snow-wind-001/MecanumWheelvehicle/3D/IMG_20170406_211856_AO_HDR.jpg

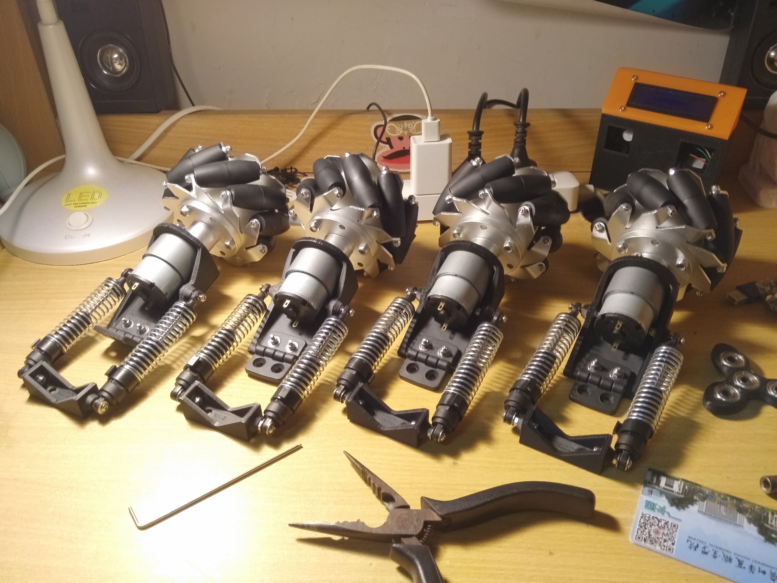
3D/IMG_20170406_211856_AO_HDR.jpg
