snow-wind-001/MecanumWheelvehicle/3D/IMG_20170523_214143_AO_HDR.jpg

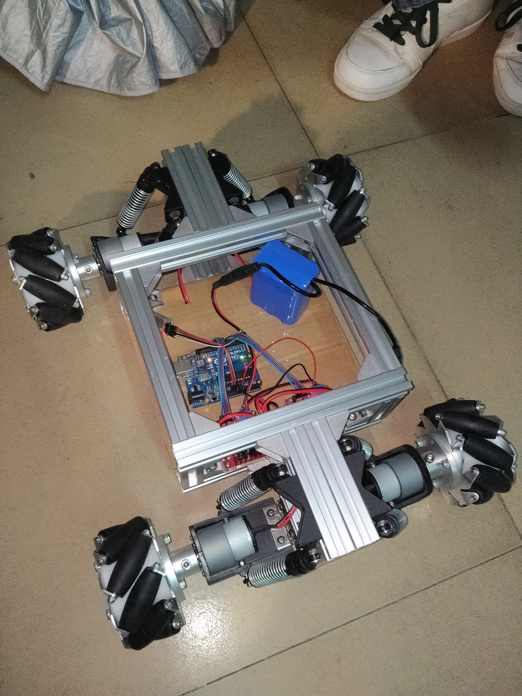
3D/IMG_20170523_214143_AO_HDR.jpg
