snow-wind-001/MecanumWheelvehicle/Code/docs/代码与电路一致性复核_v1.md

# 代码与电路一致性复核 v1

2026-10-25。范围：当前 STM32 编译工程、MAVLink / ROS / Pi 部署、参数与健康保护，以及最终原生工程归档中的 PCB2 / PCB3_1。只发布最终文件，历史备份、过程日志及候选路由保留在本地。

## 结论与依据

本轮修复了代码中的具体缺陷，当前 80 项主机测试通过，STM32 全量构建零告警，ESP32 与两个 ROS 包构建通过。归档中 64 个必需 MCU 引脚与引脚基线一致，主 GPIO 宏匹配；A/B 60 位信号接口、8 位电源接口匹配。该检查不等于所有外设已在实板正常工作，也不是工业验收证明。

电路依据为 `PCB/backups/PCB3_1_routing_complete.epro2`，不是旧版导出或当前未保存窗口。机器报告保存归档 SHA256；后续如果更换归档，应重跑检查。

- PCB2 UUID：`9fb4ea4c3f4a2c99`，MCU U10 / STM32F429ZGT6，LQFP144。
- PCB3_1 UUID：`d5bab27b5a49d1b7`，电源与电机驱动板。
- 程序入口：`Code/MecanumB_Control/Makefile`，默认 `VEHICLE_LINK_PROTOCOL_MAVLINK=1`。
- 仅发布一份完整 EDA 归档和 `3D/Vehicle Layout v15.blend`；本轮未修改机械几何、PCB 元件布局或布线。

## 已修复问题

| 问题 | 修复与验证 |
| --- | --- |
| 启动擦除 Flash 期间可能被外部看门狗复位 | 不再擦除空白槽；必须擦除时在 `.RamFunc` 中关中断轮询，每 20 ms 为 PG12 提供 WDI 下降沿，电机 ARM/MOE 保持关闭。3 s 超时停止喂狗等待外部复位；完成后刷新 Flash 缓存。ELF 检查确认函数位于 SRAM 且没有子程序调用；实际擦除波形仍待实测 |
| 参数保存与解锁竞争 | 同一临界区检查 DISARMED、无待确认授权、配置有效并获取 `maintenance`。MAVLink / legacy 解锁和运动许可全部受维护联锁约束；编程进行中不能被截止时间提前解锁，完成后保持 20 ms 才释放 |
| 电流阈值与驱动/电机不匹配 | 根据用户提供的 MG370 单电机约 1 A 堵转电流，采用待标定 1.2 A / 20 ms 过流和 0.8 A / 低速 / 500 ms 堵转阈值，可用宏覆盖；新增约 1 A 输入的堵转测试 |
| 清除计时在滞回带中累计 | 过流、欠压、过温只在满足恢复条件时连续计时；条件中断即清零。添加“长时间滞回带 + 一次恢复采样不能清故障”测试 |
| 损坏 Flash 头部使后续记录不可见或重写非空槽 | 固定 84 字节槽逐项扫描，跳过非空损坏记录；只在完全擦除槽追加。测试模型严格执行 Flash 位只能 1→0，覆盖损坏中间头、损坏尾、CRC 回退与满槽轮换 |
| SBUS 高电平重新授权、缓存样本延长租约 | LOW→HIGH 只消费一次；未出现新 LOW 时不能在上锁后自动重解锁。租约以物理帧时间为准，相同时间戳不续租；failsafe 立即撤权。生产默认仍关闭本地运动权，专门以启用宏编译测试 |
| Pi 默认部署启动 legacy 节点 | `mecanum-bridge.service` 改为启动 `mecanum_mavlink`；配置也须使用同名包的 YAML，避免协议不匹配 |
| 关机 ACK 丢失后重试被拒绝 | 对已接受的同一 Pi 关机请求幂等 ACK，不重复触发电源状态机；READY 只在接受 ACK 后因关机而拉低 |
| 无效 ADC 仍可能上报旧 NTC 温度为有效 | NTC 有效性必须同时满足 ADC 有效；添加启用 NTC 编译分支测试 |
| CPU 负载计算无符号下溢与 DWT 频繁回绕 | 空闲百分比先限幅再相减；DWT 先扩展再转为微秒用于 RTOS 统计。统计计数仍为 32 位，约 71 分钟回绕；跨回绕瞬间的任务统计存在上游内核精度边界，不能作为高精度测量 |

## 硬件映射与电气参数

| 项目 | 归档连接/名义值 | 程序处理 |
| --- | --- | --- |
| FL/FR/RL/RR PWM | PE9/PE11/PE13/PE14，TIM1_CH1–4 | 20 kHz PWM，硬件 Break 与许可共同约束 |
| 编码器 | FL PA15/PB3；FR PA6/PA7；RL PB6/PB7；RR PA0/PA1 | TIM2/3/4/5，16/32 位回绕差分；方向与 CPR 待标定 |
| 驱动故障/急停 | PG4–PG7、PG11；PE15 MOTOR_INHIBIT | 故障锁存、撤销授权、关闭 ARM/MOE |
| 电流 ADC | PC0–PC3 = IN10–13；板间 39/41/43/45 | 50 mΩ × 10 V/V = 名义 0.5 V/A，ADC 按轮序采集 |
| 电压 ADC | PC4/PC5 = IN14/15；板间 47/48 | 120 kΩ / 10 kΩ，即分压比 13 |
| 外接 NTC | PB1 = IN9；板间 49 | 电路为 10 kΩ 上拉、100 Ω 串联及 100 nF；探头型号/Beta 未确认，默认关闭 |
| Pi | USART6 PG14/PG9，921600 8N1 | MAVLink 双通道之一；READY PD0、HALTED PD1、关机请求 PC6、切电 PD3 |
| ESP32 | USART1 PA9/PA10，921600 8N1 | 桥的 RX16/TX17 对应 MCU TX/RX，注意按信号方向接线 |
| 外部看门狗 | A U11 TPS3431，EN/SET1 高，CWD 经 10 kΩ 上拉 | 名义 200 ms；PG12 WDI 经板间 31，WDO 经板间 55 接 MCU 25 NRST |
| 预留未接 | PD8 LD06_TX、PC10/PC11 POSE、PE0/PE1 LOG | 归档没有对应 MCU 铜网络；软件初始化不代表具有可用硬件接口 |

STSPIN948 的 MODE1/2/3 为 0/1/0，采用双独立全桥固定关断时间限流。REF 网络名义 1.5 V、增益 10、50 mΩ，推导硬件电流阈值约 3 A；旧 6 A 过流、3 A 堵转设置不能作为这台 1 A 堵转电机的合理保护基线。推导基于电路和器件关系，未包含误差与真实 PWM 波形校准。[STSPIN948 数据手册](https://www.st.com/resource/en/datasheet/stspin948.pdf)

TPS3431 在当前 CWD/SET1 配置下名义 200 ms，范围 170–230 ms。推迟内部 IWDG 初始化不能规避一直启用的外部看门狗，因此必须处理 Flash 忙时 CPU 无法从同组 Flash 取指的问题。[TPS3431 数据手册](https://www.ti.com/lit/ds/symlink/tps3431.pdf)、[STM32F4 参考手册 RM0090](https://www.st.com/resource/en/reference_manual/dm00031020-stm32f4xxx-advanced-armbased-32bit-mcus-stmicroelectronics.pdf)

## 参数存储与启动

程序 Flash 为 768 KiB；扇区 10/11 分别从 `0x080C0000` / `0x080E0000` 开始，各 128 KiB。每条记录 84 字节：魔数、版本、配置长度、序号、CRC32、boot_id 与 64 字节配置；每扇区容纳 1560 条记录。

启动扫描最新有效记录，CRC 与参数范围都通过后 `configured=1`；无有效记录则 `configured=0`，拒绝解锁。运行期仅 DISARMED 且配置稳定 750 ms 才追加，永不运行期擦扇区；写满下次启动轮换。保存后回读验证，失败通过 `cfg_err` 诊断；连续编辑时只清除对应版本的 dirty。

上电和加载有效参数都不会自动解锁。Pi 源仍必须满足真实 READY、电源和 HALTED 联锁；其他来源也必须显式授权并具有新鲜指令与租约。整片擦除会清掉持久化参数，烧录策略必须保留参数区。

## 健康保护的真实边界

- 过流：>1.2 A 持续 20 ms；全部轮 ≤0.6 A 连续 1 s 恢复。阈值来自电机规格输入，未完成电流零点/量程校准。
- 堵转：有运动许可、占空比绝对值 >0.1、采样电流 >0.8 A、轮速 <1 rad/s 持续 500 ms；条件消失 2 s 恢复。
- 欠压：按假定 4S 单体 <3.3 V 持续 1 s 触发，>3.5 V 连续 2 s 恢复；电池类型与分压实测须确认。
- NTC：过温分支支持 75 °C / 1 s 与 60 °C / 2 s 恢复，但默认 `VH_NTC_ENABLED=0`，现版不能宣称已启用温度保护。
- ADC 无效持续 1 s 产生传感器故障；有效性恢复不自动恢复运动授权。
- SOC 只按 4S 电压线性估算，不是 BMS，不测单体、库仑量或均衡。
- TIM8 ADC 与 TIM1 PWM 同为 20 kHz，但并未硬件锁定采样相位；DMA 当前交接末次扫描，不是每 PWM 周期平均电流。驱动低侧采样在某些占空比/续流状态可能低估实际电流，必须台架验证有效采样窗口，不能仅凭换算公式证明可靠保护。

## FreeRTOS、Pi 与验收

7 个静态任务：Safety 15、Control 14、HostRx 11、Imu 10、SensorRx 8、Telemetry 7、Power 6。Control 由 TIM6 通知，目标 1 kHz；维护期间硬件输出关闭且不计入常态抖动样本。CPU、最大/最近抖动、7 个任务栈高水位有遥测通路，尚无实测数值。

MAVLink 关机只允许 Pi 通道、`param1=0/param2=2`、未运动且 READY 有效；接受后 inhibit，再等待停轮与真正内核 HALTED，最后单次切电。ROS 不伪造 HALTED。Pi 的 `config-halted-pending.txt` 未作为已验证配置启用；不合并它时，不能指望 Linux 自动提供 HALTED，系统应超时保电并报故障。

## 软件验证结果

| 检查 | 结果 |
| --- | --- |
| STM32 全量 GCC 构建 | 成功，0 warning；FLASH 78,844 B / 768 KiB，RAM 54,712 B / 192 KiB，CCM 0 |
| 主机 C / Python / ROS / PTY | 80 项通过，0 跳过；包含本地 SBUS 和 NTC 启用分支 |
| ROS colcon | mecanum_mavlink、mecanum_bridge 两包构建成功；部署主线仅启动前者 |
| ESP32 PlatformIO | 成功；Flash 747,369 B，RAM 46,568 B |
| 时钟配置 | HSE 8 MHz，PLL 8/360/2，SYSCLK 180 MHz；APB1 45/APB2 90 MHz |
| 原生归档接口 | 64 个必需 MCU 信号匹配、5 个预留未接明确记录；60 位信号/8 位电源接口匹配 |
| ELF SRAM 擦除函数 | 地址 0x20000098，228 字节，无调用指令；BIN 未侵入参数区 |

可复现命令见根 README。最终精简证据为 `Code/reports/verification_final_v1.json`、`hardware_contract_v1.json`、`firmware_image_contract_v1.json`。完整过程日志只在开发机保留。

未完成的硬件验收：SWD 烧录和复位原因记录、Flash 首写/轮换/断电恢复、WDI/READY/HALTED 波形、ADC/PWM 相位与换算、NTC 型号、编码器方向、单轮限流台架、堵转/欠压故障注入、HIL、持续运行统计和温升。当前证据支持继续台架联调，不能写成“实板全部无误”或“达到工业认证”。
