snow-wind-001/MecanumWheelvehicle/Code/docs/参数持久化与健康保护_v1.md

> 当前复核：见 [代码与电路一致性复核_v1.md](代码与电路一致性复核_v1.md)。历史构建数值与旧测试条目保留为记录；本轮 80 项测试和最新链接报告为当前软件验证证据。

# 参数持久化、健康保护与宿主闭环 v1

2026-10-25。本文记录针对五项已知缺口完成的固件与宿主改动：参数掉电保存、电气健康保护、SBUS 本机运动权、Pi READY/关机闭环、运行时统计。所有结论来自本机编译、C 单元测试与 ROS 2 PTY 联测；**没有一项经过实板、HIL 或示波器验证**，凡需实板测量才能给出的数字均在文中标出，不得用估算值替代。

## 1. 标定参数持久化

### 1.1 介质与记录

参数写入 STM32F429 内部 Flash 的两个 128 KB 扇区，构成 A/B 追加日志：

| 项 | 值 |
| --- | --- |
| 槽 A / 槽 B | `0x080C0000` / `0x080E0000`，各 128 KB（扇区 10、11） |
| 链接脚本 Flash | 768 KB（`STM32F429ZGTX_FLASH.ld`），其余 256 KB 留给参数日志 |
| 记录格式 | `magic 0x4D435631 ("MCV1")` + `version 1` + `seq` + `boot_id` + 84 字节总长 + CRC32 |
| 配置镜像 | 64 字节 v1 PARAM 镜像，使用 legacy PARAM 编码；MAVLink 的 20 个命名参数先转换为此配置镜像 |
| 校验 | 装载前 CRC32 与 `vc_config_valid()` 双重校验 |

记录只追加，运行期**从不擦除**。扇区擦除仅发生在启动阶段、独立看门狗启动之前；当前扇区写满时运行期停止写入，下次启动扫描后擦除较旧槽并继续追加。

空白槽直接使用、不做无意义擦除。坏 magic/部分编程记录占用一个固定 84 字节槽，继续扫描后续有效记录并跳过非擦除尾部，禁止向已写位重编程。启动擦除使用 `.RamFunc` 的 RAM 轮询函数，关中断且电机许可关闭，每 20 ms 为一直启用的 TPS3431 提供下降沿；3 s 超时停止喂狗等待外部复位。擦除完成刷新 Flash 缓存。该路径已编译和反汇编检查，仍待真实擦除/断电试验。

### 1.2 启动流程

1. `vehicle_app_init()` 先初始化两个 `VsSlot` 并调用 `vs_store_init()` 扫描两个槽，取序号最大且 CRC 与配置校验都通过的记录。
2. 有效记录直接填入 `link.config`，置 `configured = 1`、`config_revision = 1`，随后 `vc_init()` 立即使用该配置。
3. 无有效记录时保持 `configured = 0`，解锁继续被拒绝——固件不再要求 Pi 每次上电重发参数，但没有测量值时依然不可解锁。

### 1.3 运行期写入

`config_store_step()` 由 Telemetry 任务每 1 ms 调用：

- 仅当 `config_dirty` 被置位、链路状态为 `VL_DISARMED`、且距最近一次修改已过 750 ms 才写入（合并连续 `PARAM_SET`）。
- 在同一临界区检查 DISARMED、无待确认解锁并获取 `link.maintenance`；所有 ARM 与运动许可路径拒绝维护窗口，硬件 ARM/MOE 拉低。编程期间 `store_programming` 禁止提前释放；完成后再保持 20 ms，Control 才解除窗口。仅该禁止运动窗口内跳过抖动/超时统计。
- 写入成功时同步 `config_store_seq`；若期间参数又被修改，`config_dirty` 保持置位。写入失败时累加 `config_store_errors`，只在配置版本未变化时清除脏标志，不阻塞任务。
- 每次写入后回读并复核 CRC，只有回读通过才算成功。

`cfg_rev`、`cfg_seq`、`cfg_err` 通过命名遥测上报，供宿主确认掉电保存是否生效。

已知限制：只有两个扇区，没有额外磨损均衡；按每次修改一条 84 字节记录计算，单扇区可容纳 1560 条记录。参数只在解锁前变化时写入，正常使用中写入次数很少。

## 2. 电气健康与保护

2026-10-25 修订：阈值按用户提供的 MG370 单电机堵转约 1 A 设置为待标定配置。A 板 REF=1.5 V、50 mΩ、增益 10，对应固定关断时间硬件限流约 3 A；旧 6 A/3 A 软件阈值不适用。电流的 PWM 采样相位与零点仍需标定，不能视为已完成实测保护验收。

### 2.1 采样与换算

`vh_step()` 在 Control 任务中以控制周期（0.5–2 ms，越界时按 1 ms）调用，输入为 7 路 ADC：FL/FR/RL/RR 电流、VBAT、VM、NTC。

| 量 | 换算 | 依据 |
| --- | --- | --- |
| 相电流 | `(adc/4095×3.3 − offset) / 0.5` A | STSPIN948 内置 10 V/V 放大、50 mΩ 采样电阻 |
| 电池/母线电压 | `adc/4095×3.3×13` mV | 120 kΩ/10 kΩ 分压 |
| NTC 温度 | Beta 方程（10 kΩ 上拉、R25 10 kΩ、B 3950） | 默认 **关闭**，见 2.4 |
| SOC | 4S 线性：`(cell_mv − 3400)/(4200 − 3400)`，限幅 0–1 | 仅电压估算，非库仑计量 |

### 2.2 阈值与锁存

| 保护 | 触发 | 清除 | 故障位 |
| --- | --- | --- | --- |
| 过流 | 任一相 \|I\| > 1.2 A 持续 20 ms | 全部相 ≤ 0.6 A 连续 1 s | `VL_FAULT_OVERCURRENT` (0x08) |
| 堵转 | 已授权、占空比 > 0.1、\|I\| > 0.8 A 且 \|ω\| < 1 rad/s 持续 500 ms | 条件消失 2 s | `VL_FAULT_STALL` (0x10) |
| 过温 | NTC > 75 °C 持续 1 s | < 60 °C 持续 2 s | `VL_FAULT_OVERTEMP` (0x20) |
| 欠压 | 单体 < 3.3 V 持续 1 s | 单体 > 3.5 V 持续 2 s | `VL_FAULT_UNDERVOLT` (0x40) |
| 传感器丢失 | ADC 无效持续 1 s | ADC 恢复 | `VL_FAULT_SENSOR` (0x80) |

健康故障并入 `physical_faults()`，与急停、充电中、电源告警等硬件位一起交给 `vl_tick()`：任一位存在都会使解锁被拒绝，并使正在运行的运动立即停止。低压不会再"只报警不动作"。

### 2.3 上报

- `BATTERY_STATUS`：电压取 `vbat_mv`，`battery_remaining` 由 SOC 给出，SOC 无效时保持 -1（未知）。
- 命名遥测：`i_fl/i_fr/i_rl/i_rr`（A）、`ntc_c`、`soc`、`stall`（位掩码）。未测量的通道发送 NaN，宿主不得将其显示为 0。
- ROS 节点汇总为 `/diagnostics` 的 `electrical` 状态块，见第 4 节。

### 2.4 尚未验证、因此保守关闭的项

- **NTC 默认关闭**（`VH_NTC_ENABLED 0`）：原理图已确认 10 kΩ 上拉、100 Ω 串联及 100 nF；外接探头型号/Beta 与实板换算尚未核对，用猜测的分压比会给出"看起来合理但错误"的温度并误触发过温保护。校准后以编译宏启用。
- 电流零点偏移 `VH_CURRENT_OFFSET_V` 默认为 0。实板需在电机断电、占空比为 0 时测量零点并写入。
- 电流方向符号沿用 ADC 原始符号，绝对值用于保护；未假定"放电为正"。
- 仍**没有 BMS**：没有单体电压、库仑计量、均衡或温度组，SOC 只是线性电压估算。

## 3. 本机 SBUS 运动权（编译期关闭）

固件保留 `VL_RC` 作为独立运动来源，默认 `VM_SBUS_AUTHORITY 0`，即只上报 `RC_CHANNELS`、不授予运动权。置 1 后：

- 每个通过帧格式校验且非 failsafe 的新 SBUS 帧，按物理采样时间续租 250 ms（SBUS 本身无 CRC，同时间戳缓存帧不续租）（`VL_RC_LINK_TIMEOUT_US`），遥控链路的租约与 Pi 的 2 s 租约相互独立。
- 解锁开关为 CH5（`VM_SBUS_ARM_CHANNEL`）：必须先见到低于 1500 µs，再出现高于 1500 µs 的上升沿，才发起解锁，避免上电即解锁。
- 摇杆到车体速度：CH2→vx、CH1→vy、CH4→-yaw_rate，按 `VM_RC_MAX_SPEED_MPS` / `VM_RC_MAX_YAW_RATE` 折算。
- failsafe 帧立即撤权；250 ms 无新物理帧也撤销运动权并进入 `FAILSAFE`。

保持关闭的原因：CH5 的实际通道映射与接收机 failsafe 输出值尚未在实机上确认。用错通道会导致"遥控一上电就解锁"。

## 4. Pi READY 与关机闭环

### 4.1 固件侧

- `MAV_CMD_PREFLIGHT_REBOOT_SHUTDOWN (246)` 仅接受 Pi 通道、`param1 = 0`（不重启自驾仪）、`param2 = 2`（关闭伴飞计算机），且要求：Pi READY 有效、无电源禁止、无待处理解锁、状态为 `DISARMED`/`FAILSAFE`/`FAULT`。
- 接受后立即置 `power_inhibit`（此后所有新的授权请求被拒绝）并置 `shutdown_requested`；PowerTask 依次等待停轮、内核 HALTED，再单次发出切电脉冲。超时不强切、不自动重试。
- 其余通道、参数组合、已解锁状态一律 `MAV_RESULT_DENIED`。

### 4.2 宿主侧（`mecanum_mavlink`）

- 节点取得 `/dev/gpiochip0` 的 BCM GPIO17（READY），默认在链路心跳新鲜时拉高，心跳失效时立即拉低。未配置 GPIO 芯片时该功能关闭，仅用于台架，**整车上禁止为空**。
- 新增 `/mecanum_mavlink/shutdown_pi`（`std_srvs/Trigger`）：要求已上锁且有新鲜心跳；发送命令并等待 `COMMAND_ACK`。仅在接受后拉低 READY 并置 `shutdown_pending`（此后不再拉高，服务不可重复请求）。被拒绝或无 ACK 时释放挂起状态，READY 由定时器恢复。
- 节点退出时先拉低 READY 并释放该线，作为"宿主离开"的硬件信号。
- 内核侧仍是既有方案：GPIO27 低有效请求交给 `gpio-shutdown`/systemd-logind 执行有序关机，`gpio-poweroff` 等待 A/B 接线与波形验证后再启用。详见 [Pi 部署说明](../pi/README.md)。

### 4.3 上报

诊断 `serial link` 增加 `ready`（`True`/`False`/`n/a`）与 `shutdown_pending`。

## 5. 运行时证据

### 5.1 固件采集

| 指标 | 来源 | 说明 |
| --- | --- | --- |
| 控制周期抖动 | Control 任务的自唤醒周期与 1 ms 之差，单位 µs | 启动后 100 ms 稳定窗口内与 Flash 维护窗口内不采样；只记录绝对值，分别上报最近值与上电以来最大值 |
| CPU 负载 | DWT 扩展后换算的微秒计数，Idle 与总量每 1 s 求差 | 1 s 内 `busy = 100 − idle_delta/cycle_delta`，限幅 0–100 |
| 栈高水位 | `uxTaskGetStackHighWaterMark()` | 7 个任务：安全、控制、宿主、遥测、电源、IMU、接收；单位字（4 字节） |
| 参数持久化 | `VsStore` 序号与错误计数 | 见第 1 节 |

DWT 原始计数约 23.8 s 回绕，采集先扩展再换算为微秒。RTOS 统计接口仍为 32 位，约 71 分钟回绕，上游内核跨回绕边界的统计存在精度限制；这些值用于诊断，不是实时性验收数据。

### 5.2 上报与诊断

命名遥测新增：`stk_safe/stk_ctrl/stk_host/stk_tele/stk_pow/stk_imu/stk_rx`、`jit_us`、`jit_max`、`cpu_pct`、`cfg_seq`、`cfg_err`。

ROS 节点新增两个诊断块：

- `mecanum_mavlink: electrical`：四路电流、NTC、SOC、堵转掩码、故障位与名称。
- `mecanum_mavlink: runtime`：7 个任务的剩余栈（字）、最近/最大抖动（µs）、CPU 负载、参数序号与错误数。

WARN 条件：堵转锁存、电流/SOC 未上报、任一任务剩余栈 < 32 字、CPU > 80%、参数保存失败。ERROR 条件：故障位含过流/堵转/过温/欠压/传感器位。固件未上报时整块为 STALE，宿主不会补零。

### 5.3 尚未完成

**没有 HIL，没有烧录记录，也没有实板 1 kHz 抖动、栈高水位与 CPU 负载实测值。** 以上字段目前只在 C 单元测试与 PTY 联测中验证了"链路与换算正确"；真实数值必须上板采集后回填，禁止把默认值或估算值写成实测结论。

## 6. 最终软件验证

80 项测试全通过、无跳过；STM32 全量构建无 warning，FLASH 78,844 B、链接器 RAM 54,712 B。ESP32 与两个 ROS 包构建通过。最终精简结果见 `../reports/verification_final_v1.json`；过程日志仅本地保留。

测试覆盖损坏日志、严格 Flash 1→0 编程、满槽轮换、健康触发与连续恢复、维护期 ARM 拒绝、本地 SBUS 真实上升沿/物理帧租约、启用 NTC 的过温恢复与 ADC 失效、关机校验和 ROS/PTY READY。仍须实板验证 ADC/PWM、WDI、Flash 掉电、READY/HALTED、NTC 与电机标定及 HIL，详见一致性复核报告。
