snow-wind-001/MecanumWheelvehicle/PCB/docs/PCB3_1_布线完成复核_v1.md

# PCB3_1 布线完成复核 v1

2026-10-25。按用户“没有明显错误即可结束”的要求，本轮布线结束。

## 保存后实际板复核

| 项目 | 结果 |
| --- | --- |
| 非 GND 断点 / 孤立信号铜线 | 0 / 0 |
| GND 焊盘未接主地层 | 0 / 207 个焊盘 |
| 线、焊盘、过孔、板边、圆孔孔距、环宽、最小线宽、重复线段 | 几何检查零违规 |
| 实际覆铜对异网铜间距 | 0 违规 |
| J9 安装预留区走线/过孔侵入 | 0 |
| 焊盘网络映射 / 接插件位置 | 未改变 / 未改变 |

实际板：3210 条线段、335 个过孔、816 个原始焊盘、234 个元器件；六层板。Top、Bottom 和 Inner1 保留 GND 覆铜，Inner2/3/4 参与信号及功率走线；保留必要的焊盘至地孔短连接。VM 主干保持 60 mil，电机输出保留必要宽度。

局部元件调整：C60 向 Y 正方向 0.5 mm；U8 向 X 负方向 0.3 mm；C82 向 X 正方向 1.5 mm、Y 正方向 0.3 mm，旋转至 90°。接插件和板形保持。

嘉立创EDA原生 DRC 未取得有效报告。本结论依据保存后实际铜形、全部原始焊盘与重建覆铜的几何和连通性复核，容差 0.002 mm。

## 必须随制板文件提供的工艺要求

本版包含焊盘内过孔及驱动器散热孔。**所有 VIA 过孔按树脂填孔、整平并铜盖帽处理（VIPPO / POFV）；插件焊接孔不填充。** 本板 VIA 标称孔径为 8/12 mil（0.2032/0.3048 mm）。普通盖油不能替代本版焊盘内过孔的填孔盖帽要求。表面处理建议 ENIG。

孔位见 [填孔盖帽孔位表](../bom/PCB3_1_填孔盖帽孔位表_v1.csv)。坐标采用 PCB 编辑器原点和毫米单位，制造定位以最终钻孔文件及该表为准。工艺依据：[嘉立创过孔覆盖与填孔说明](https://jlcpcb.com/help/article/pcb-via-covering)。

## 最终发布留档

- 原生工程：`PCB/backups/PCB3_1_routing_complete.epro2`；仅上传这一份最终归档。
- 最终截图：`PCB/reports/PCB3_1_routing_complete.png`。
- 复核汇总：`PCB/reports/pcb3_1_closeout_summary.json`。
- 最终明细：`pcb3_1_completed_drc.json`、`pcb3_1_completed_connectivity.json`、`pcb3_1_completed_ground_audit.json`。
- 原始铜形快照、重建覆铜中间文件和历史备份在开发机保留，不纳入精简发布。
