snow-wind-001/MecanumWheelvehicle/3D/IMG_20170404_214613_AO_HDR.jpg

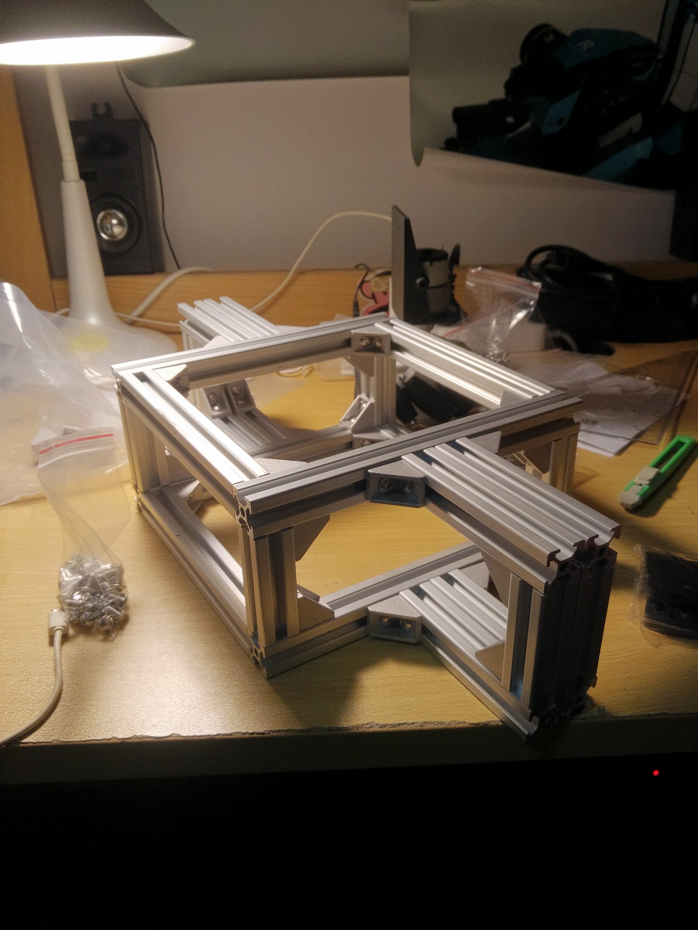
3D/IMG_20170404_214613_AO_HDR.jpg
