snow-wind-001/MecanumWheelvehicle/3D/IMG_20170409_224633_AO_HDR.jpg

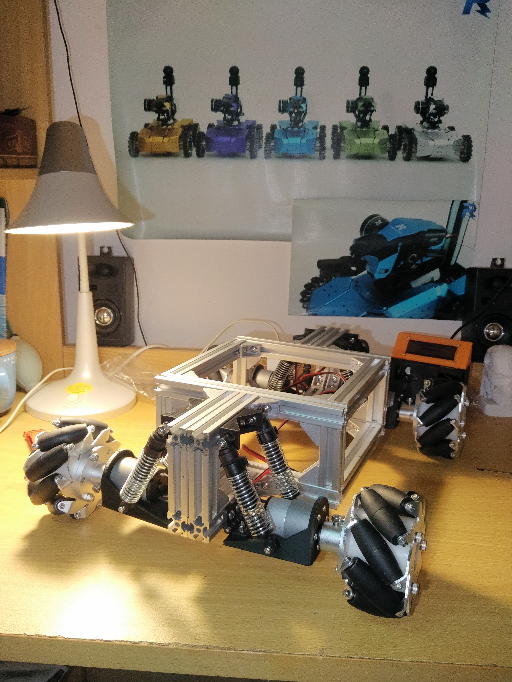
3D/IMG_20170409_224633_AO_HDR.jpg
