snow-wind-001/MecanumWheelvehicle/PCB/reports/PCB3_1_routing_complete.png

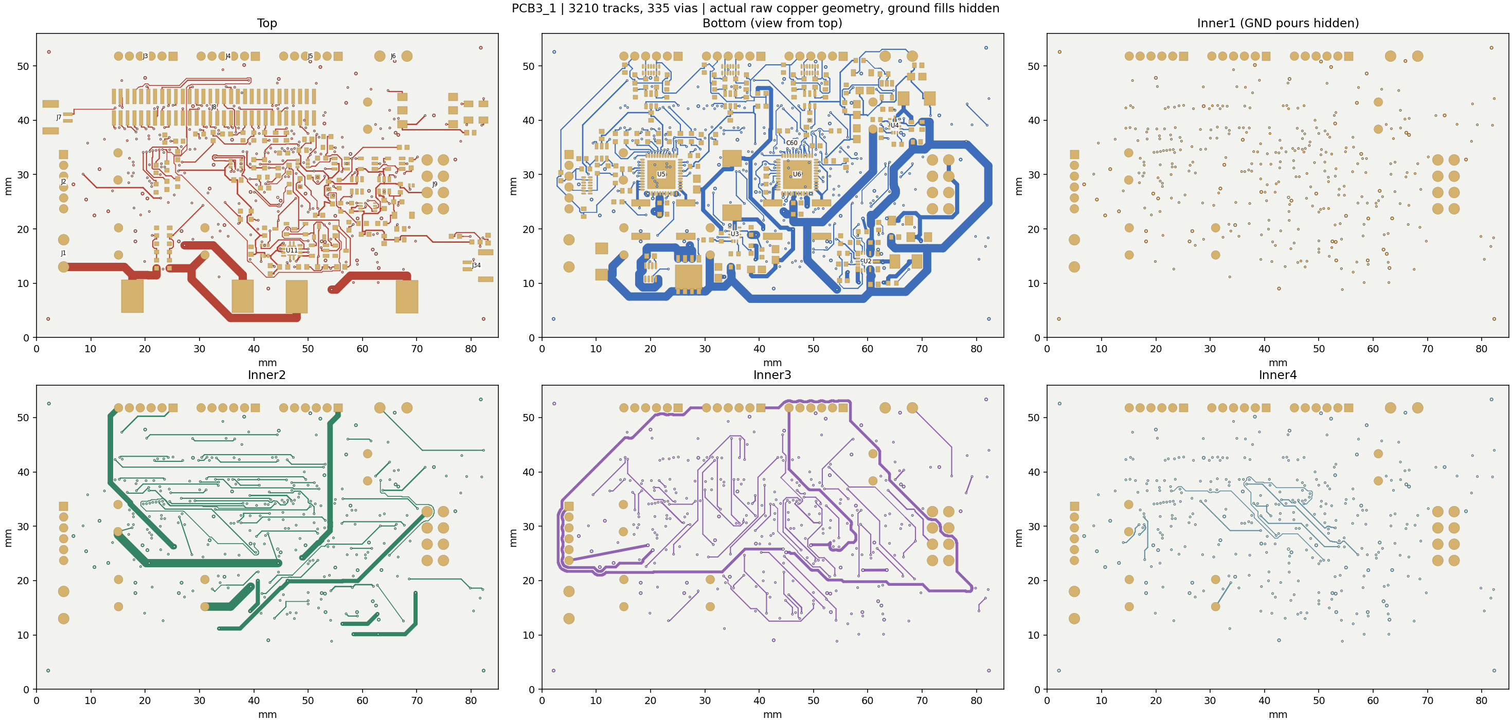
PCB/reports/PCB3_1_routing_complete.png
