snow-wind-001/MecanumWheelvehicle/PCB/bom/BOM_PCB2_final.csv

Designator | Value | Manufacturer Part | Supplier Part | Manufacturer | Description | Archive
C30 | 2.2uF | CL10A225KO8NNNC | C23630 | SAMSUNG(三星) | 容值:2.2uF;精度:±10%;额定电压:16V;温度系数:X5R; | PCB3_1_routing_complete.epro2
C31 | 2.2uF | CL10A225KO8NNNC | C23630 | SAMSUNG(三星) | 容值:2.2uF;精度:±10%;额定电压:16V;温度系数:X5R; | PCB3_1_routing_complete.epro2
C32 | 100nF | CL10B104KB8NNNC | C1591 | SAMSUNG(三星) | 容值:100nF;精度:±10%;额定电压:50V;温度系数:X7R; | PCB3_1_routing_complete.epro2
C33 | 1uF | CL10A105KB8NNNC | C15849 | SAMSUNG(三星) | 容值:1uF;精度:±10%;额定电压:50V;温度系数:X5R; | PCB3_1_routing_complete.epro2
C34 |  | CL10A106KB8NNNC | C9900126666 |  |  | PCB3_1_routing_complete.epro2
C35 | 18pF | CL10C180JB8NNNC | C1647 | SAMSUNG(三星) | 容值:18pF;精度:±5%;额定电压:50V;温度系数:C0G; | PCB3_1_routing_complete.epro2
C36 | 18pF | CL10C180JB8NNNC | C1647 | SAMSUNG(三星) | 容值:18pF;精度:±5%;额定电压:50V;温度系数:C0G; | PCB3_1_routing_complete.epro2
C37 | 100nF | CL10B104KB8NNNC | C1591 | SAMSUNG(三星) | 容值:100nF;精度:±10%;额定电压:50V;温度系数:X7R; | PCB3_1_routing_complete.epro2
C50 | 100nF | CL10B104KB8NNNC | C1591 | SAMSUNG(三星) | 容值:100nF;精度:±10%;额定电压:50V;温度系数:X7R; | PCB3_1_routing_complete.epro2
C51 | 100nF | CL10B104KB8NNNC | C1591 | SAMSUNG(三星) | 容值:100nF;精度:±10%;额定电压:50V;温度系数:X7R; | PCB3_1_routing_complete.epro2
C52 | 100nF | CL10B104KB8NNNC | C1591 | SAMSUNG(三星) | 容值:100nF;精度:±10%;额定电压:50V;温度系数:X7R; | PCB3_1_routing_complete.epro2
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
U28 |  |  |  |  |  | PCB3_1_routing_complete.epro2
U29 |  |  |  |  |  | PCB3_1_routing_complete.epro2
Y10 | 8MHz | X22EL89COI-111YLC-8M | C42448903 | YXC(扬兴晶振) | 晶振类型:贴片晶振;频率:8MHz;常温频差:±10ppm;负载电容:12pF;频率稳定度:±20ppm; | PCB3_1_routing_complete.epro2
