snow-wind-001/MecanumWheelvehicle/3D/Vehicle Assembled.SLDASM

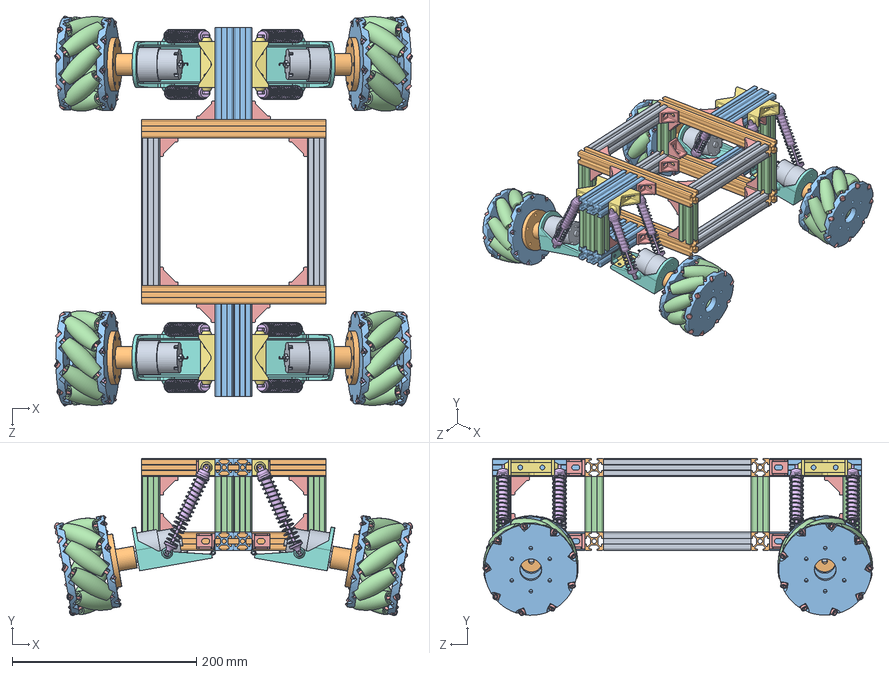
[picture p7: CAD file, 2026-10-25]
3D/Vehicle Assembled.SLDASM
388.3 x 170.8 x 423.0 mm
2020 Aluminum profile 160mm x 4
2020 Aluminum profile 200mm x 4
2020 Aluminum profile 100mm x 8
2020 Aluminum profile 60mm x 8
2020 Corner pieces x 32
Shock absorber x 8
Top absorber frame x 4
Swing arm x 4
Motor x 4
Flange x 4
Wheel hub x 8
Roller x 36
M3x72mm Screw x 36
M3 Nut x 36
Hinge 2 x 4
Hinge 1 x 4
Axle of Hinge x 4
