snow-wind-001/MecanumWheelvehicle/3D/Mecanum wheel assembled.SLDASM

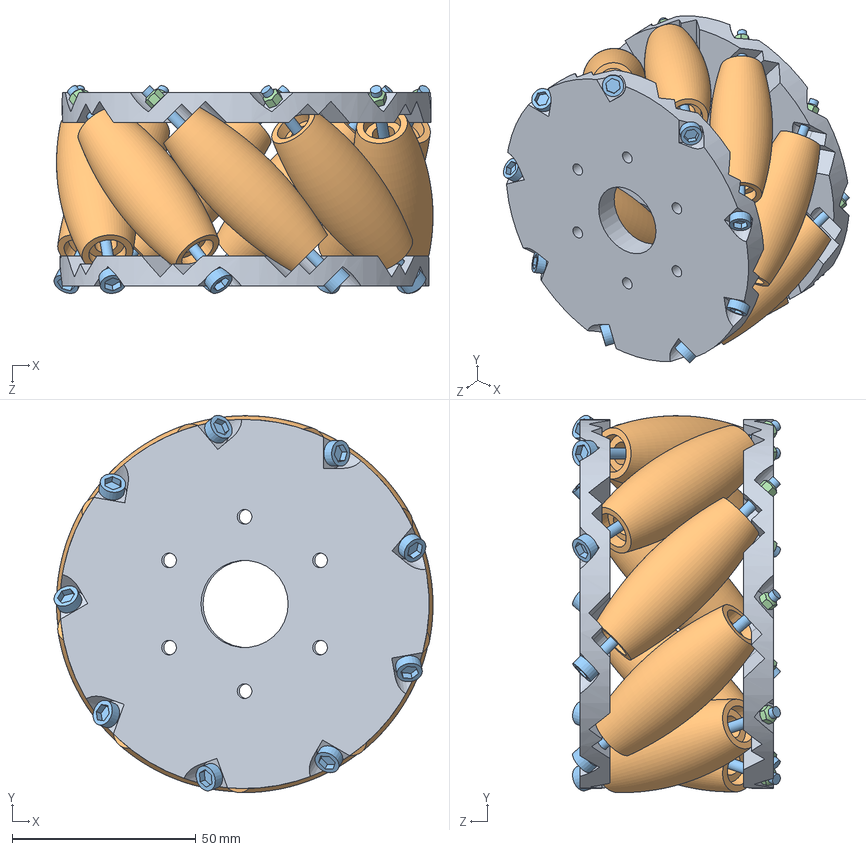
[picture p8: CAD file, 2026-10-25]
3D/Mecanum wheel assembled.SLDASM
103.2 x 102.7 x 56.5 mm
Wheel hub x 2
Roller x 9
M3x72mm Screw x 9
M3 Nut x 9
