snow-wind-001/MecanumWheelvehicle/3D/Hinge assemabled.SLDASM

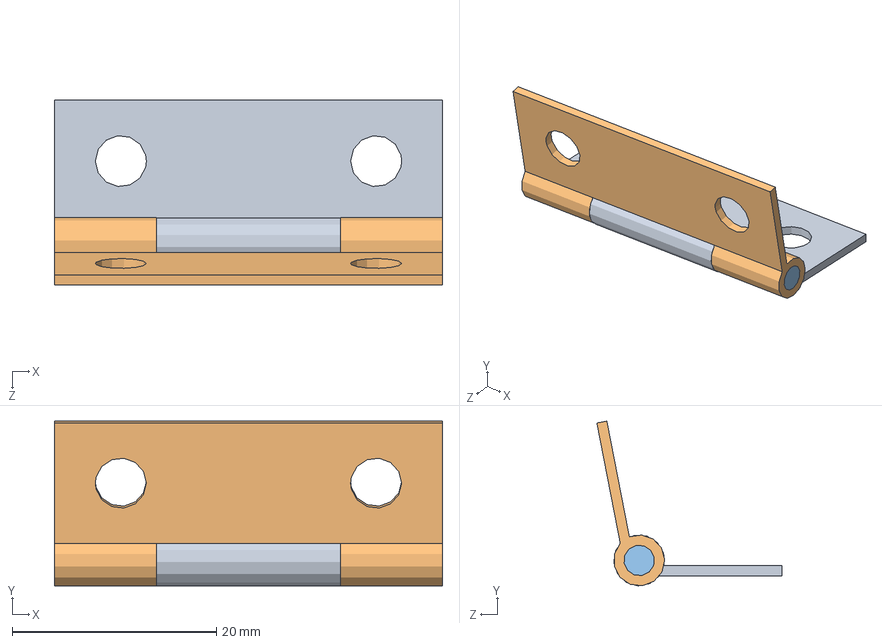
[picture p9: CAD file, 2026-10-25]
3D/Hinge assemabled.SLDASM
38.0 x 16.1 x 18.1 mm
Hinge 2
Hinge 1
Axle of Hinge
