snow-wind-001/MecanumWheelvehicle/3D/Swing arm assembled.SLDASM

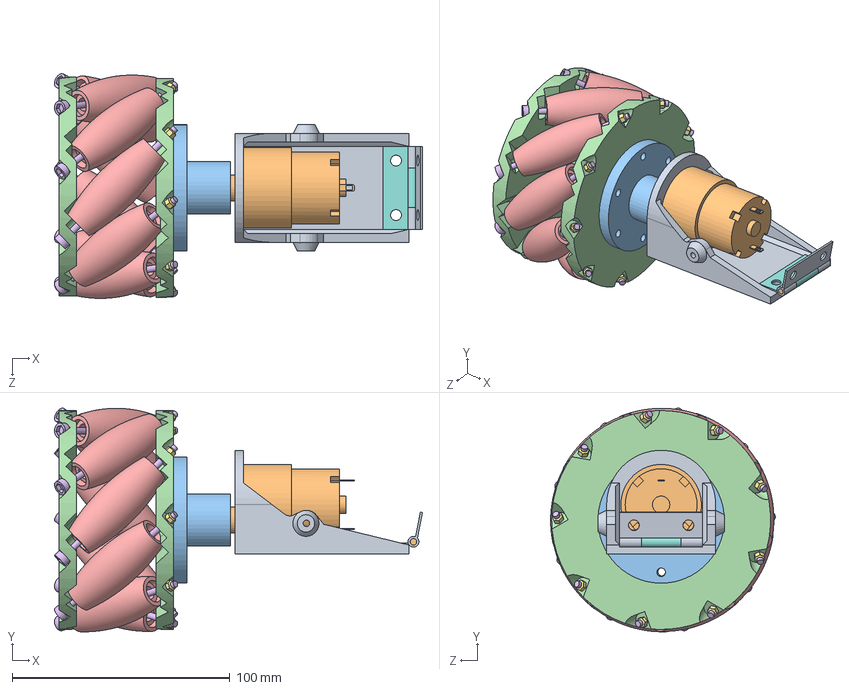
[picture p10: CAD file, 2026-10-25]
3D/Swing arm assembled.SLDASM
168.9 x 102.7 x 103.2 mm
Swing arm
Motor
Flange
Wheel hub x 2
Roller x 9
M3x72mm Screw x 9
M3 Nut x 9
Hinge 2
Hinge 1
Axle of Hinge
