snow-wind-001/MecanumWheelvehicle/3D/2020 Corner pieces.SLDPRT

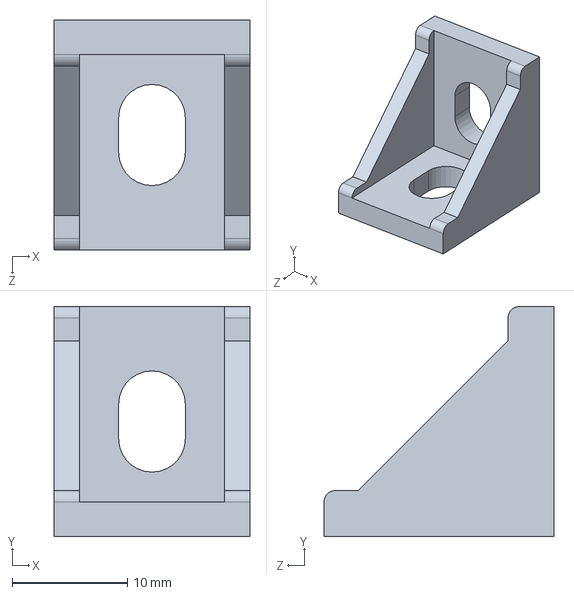
[picture p11: CAD file, 2026-10-25]
3D/2020 Corner pieces.SLDPRT
17.0 x 20.0 x 20.0 mm
