snow-wind-001/MecanumWheelvehicle/3D/Top absorber frame.SLDPRT

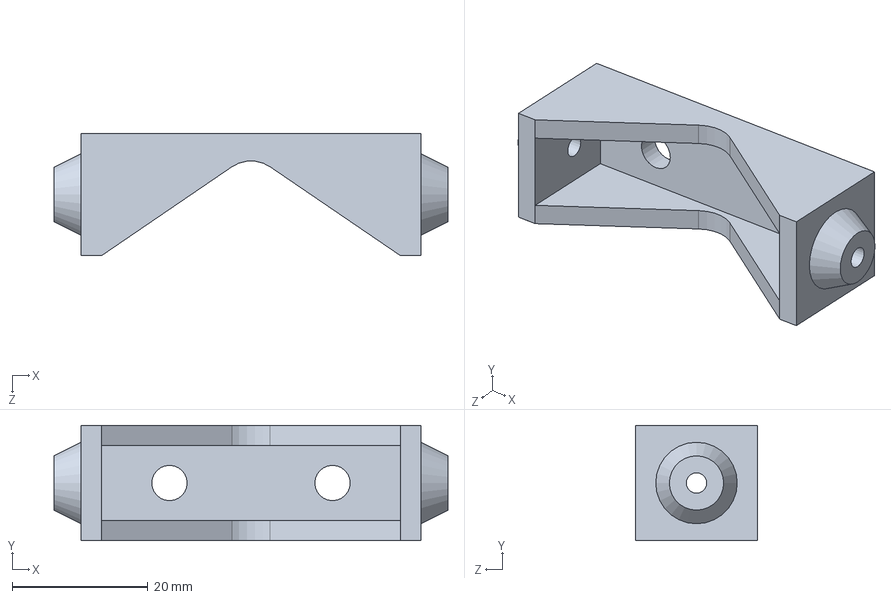
[picture p12: CAD file, 2026-10-25]
3D/Top absorber frame.SLDPRT
58.0 x 17.0 x 18.0 mm
