snow-wind-001/MecanumWheelvehicle/3D/2020 Aluminum profile 100mm.SLDPRT

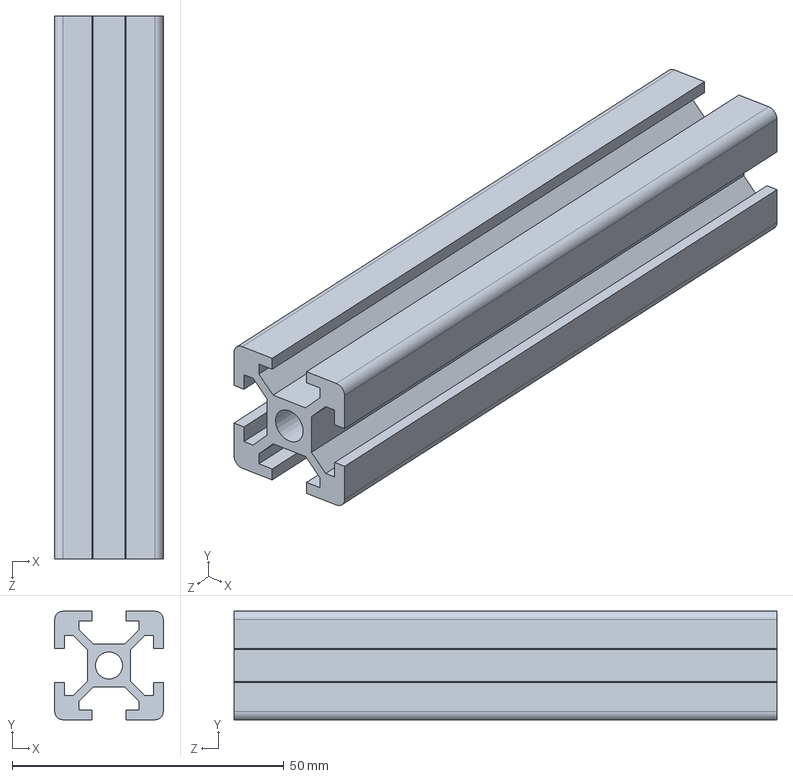
[picture p13: CAD file, 2026-10-25]
3D/2020 Aluminum profile 100mm.SLDPRT
20.0 x 20.0 x 100.0 mm
