snow-wind-001/MecanumWheelvehicle/3D/Swing arm.SLDPRT

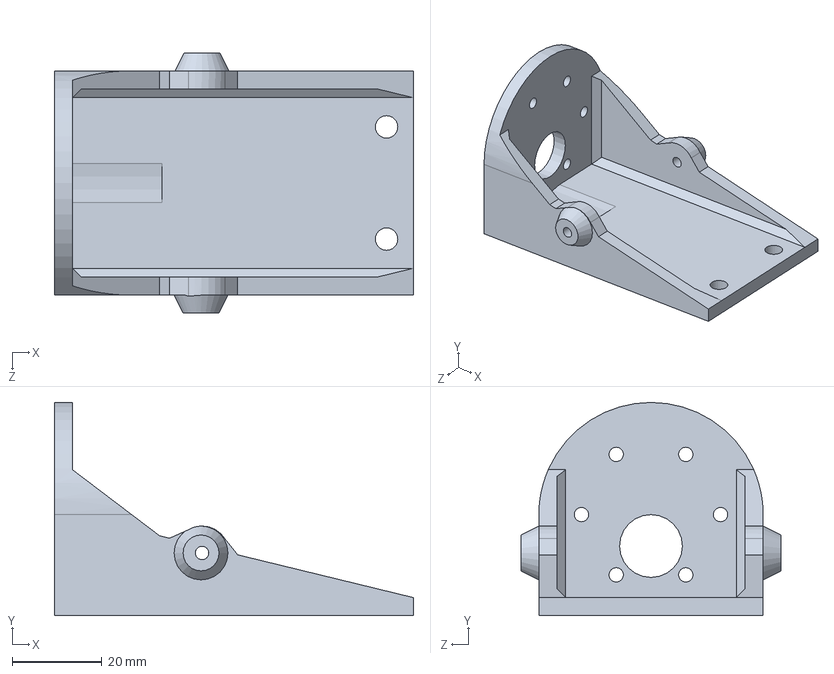
[picture p14: CAD file, 2026-10-25]
3D/Swing arm.SLDPRT
80.0 x 47.5 x 58.0 mm
