snow-wind-001/MecanumWheelvehicle/3D/Flange.SLDPRT

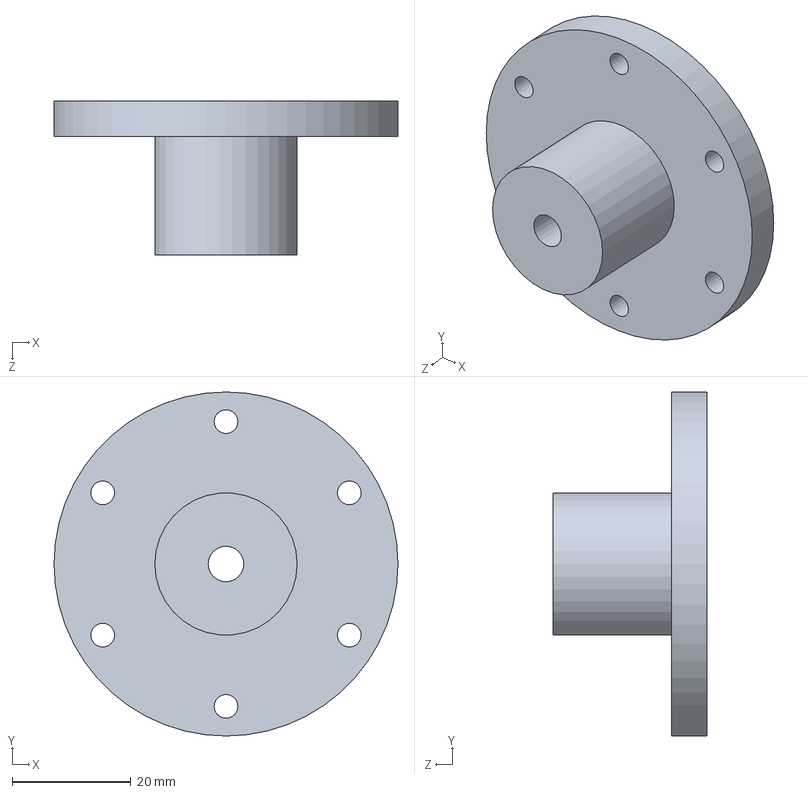
[picture p15: CAD file, 2026-10-25]
3D/Flange.SLDPRT
58.0 x 58.0 x 26.0 mm
