snow-wind-001/MecanumWheelvehicle/3D/Hinge pad.SLDPRT

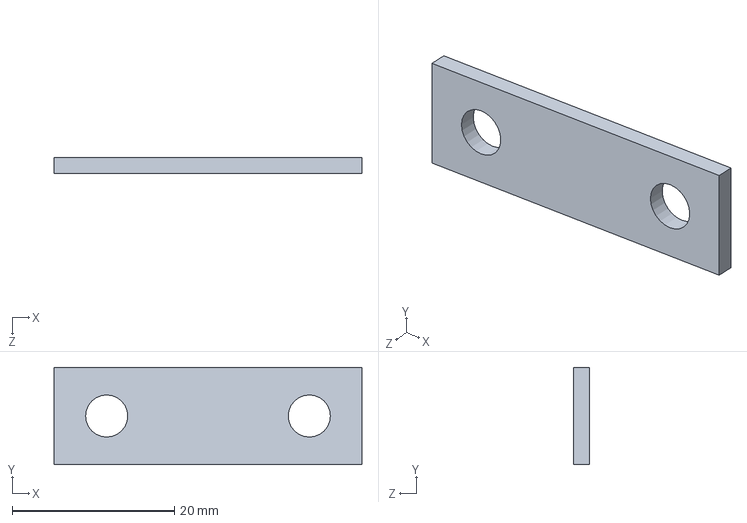
[picture p16: CAD file, 2026-10-25]
3D/Hinge pad.SLDPRT
38.0 x 12.0 x 2.00 mm
