snow-wind-001/MecanumWheelvehicle/3D/Roller.SLDPRT

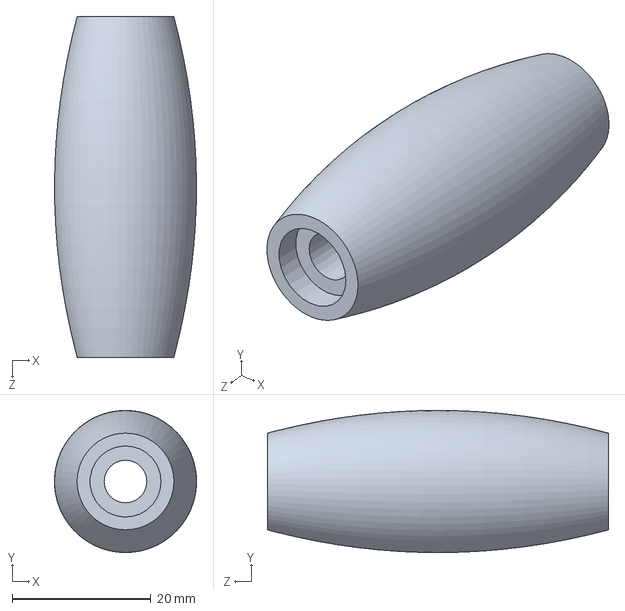
[picture p17: CAD file, 2026-10-25]
3D/Roller.SLDPRT
20.5 x 20.5 x 49.2 mm
