snow-wind-001/MecanumWheelvehicle/3D/Motor.SLDPRT

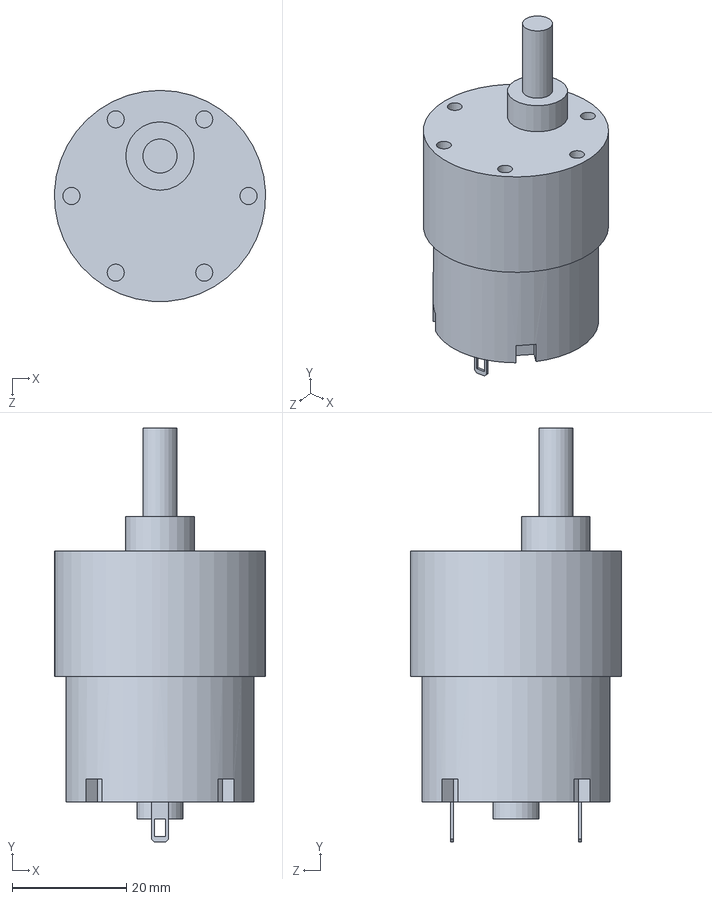
[picture p18: CAD file, 2026-10-25]
3D/Motor.SLDPRT
37.0 x 72.5 x 37.0 mm
