snow-wind-001/MecanumWheelvehicle/3D/2020 Aluminum profile 60mm.SLDPRT

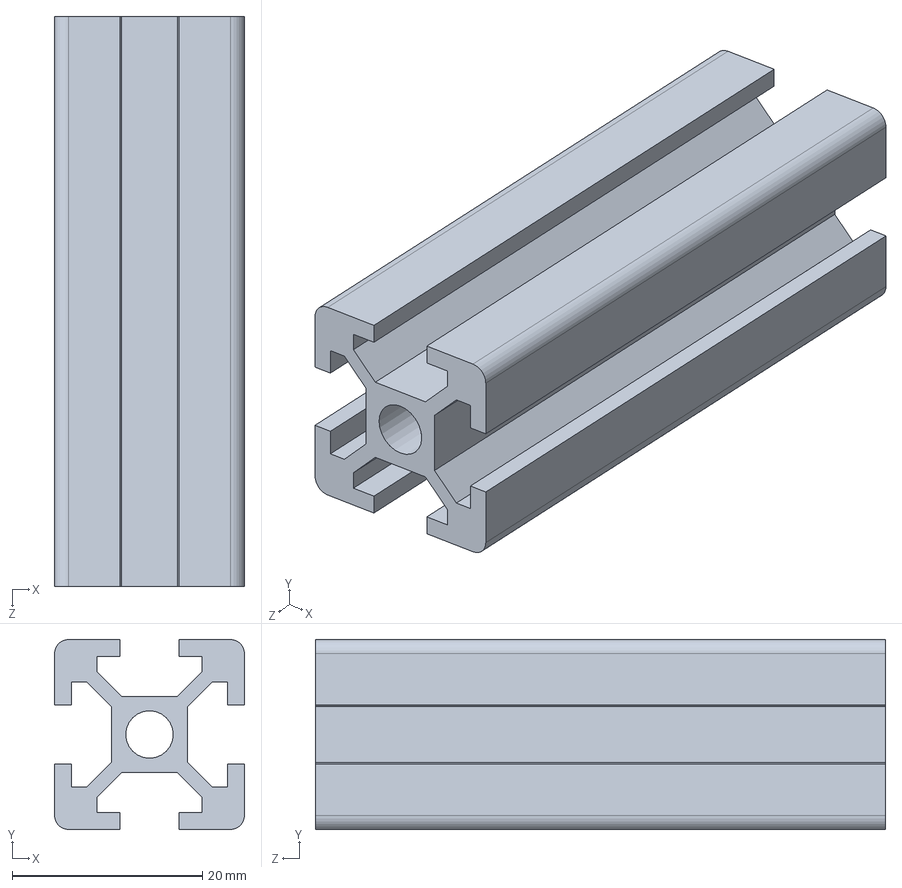
[picture p19: CAD file, 2026-10-25]
3D/2020 Aluminum profile 60mm.SLDPRT
20.0 x 20.0 x 60.0 mm
