snow-wind-001/MecanumWheelvehicle/3D/Axle of Hinge.SLDPRT

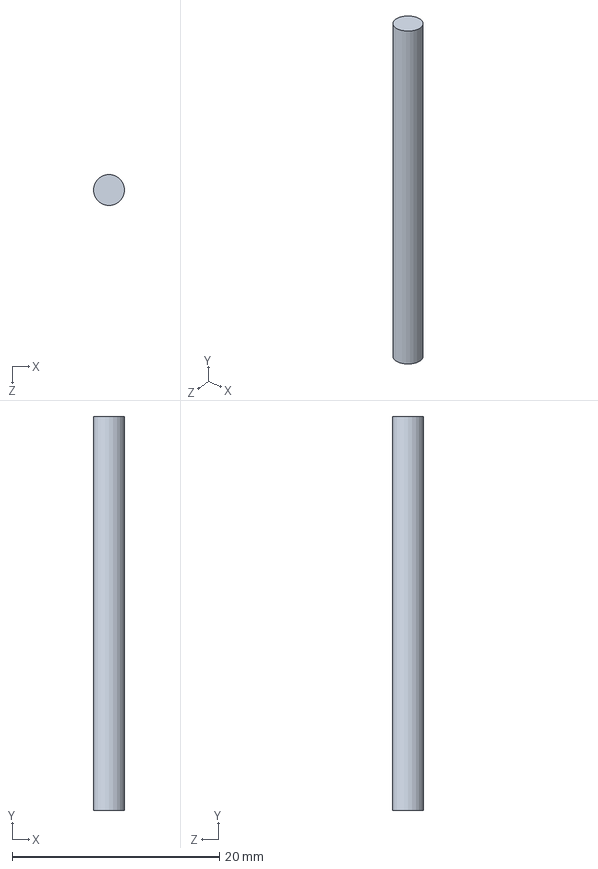
[picture p20: CAD file, 2026-10-25]
3D/Axle of Hinge.SLDPRT
3.00 x 38.0 x 3.00 mm
