snow-wind-001/MecanumWheelvehicle/3D/Hinge 2.SLDPRT

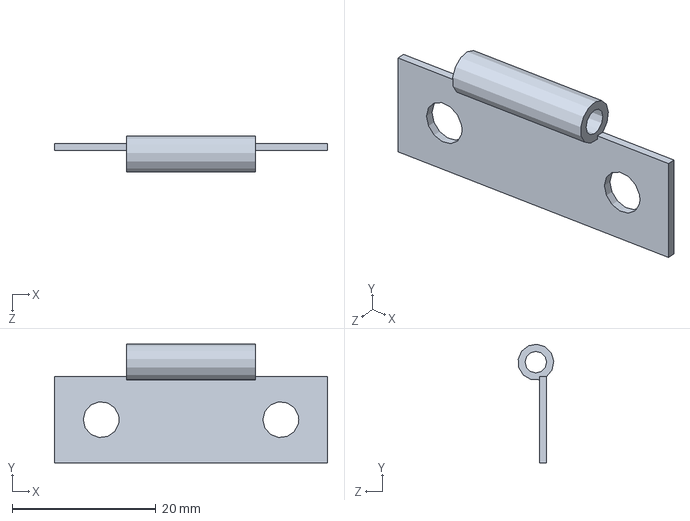
[picture p21: CAD file, 2026-10-25]
3D/Hinge 2.SLDPRT
38.0 x 16.5 x 4.96 mm
