snow-wind-001/MecanumWheelvehicle/3D/2020 Aluminum profile 160mm.SLDPRT

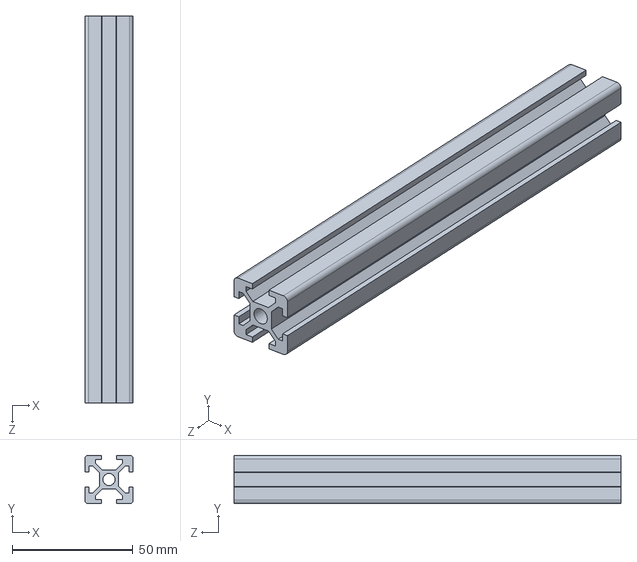
[picture p22: CAD file, 2026-10-25]
3D/2020 Aluminum profile 160mm.SLDPRT
20.0 x 20.0 x 160.0 mm
