snow-wind-001/MecanumWheelvehicle/3D/Wheel hub.SLDPRT

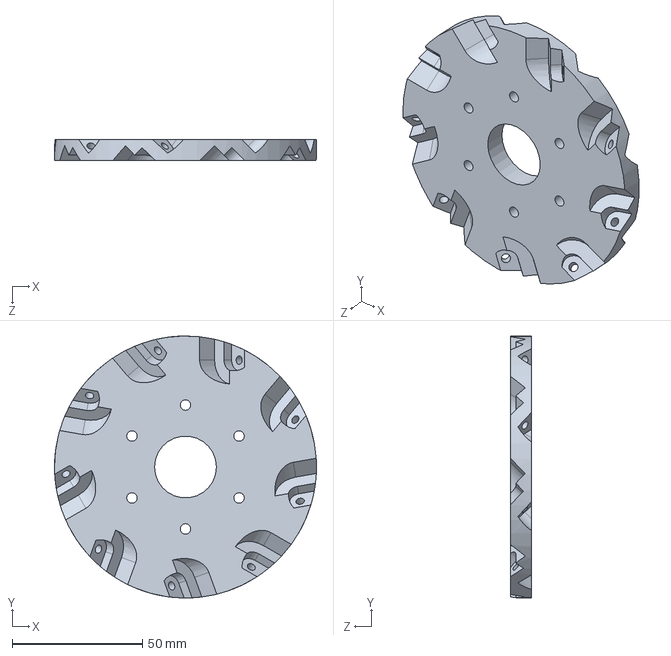
[picture p23: CAD file, 2026-10-25]
3D/Wheel hub.SLDPRT
100.4 x 100.4 x 8.20 mm
