snow-wind-001/MecanumWheelvehicle/3D/Shock absorber.SLDPRT

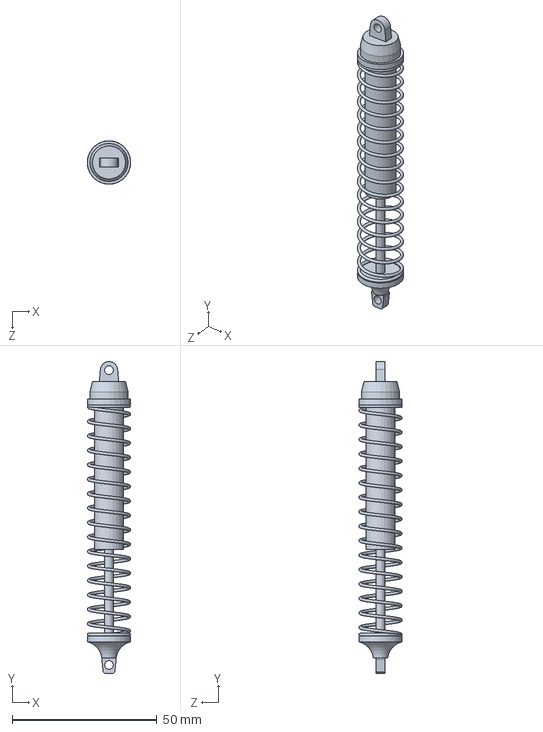
[picture p24: CAD file, 2026-10-25]
3D/Shock absorber.SLDPRT
15.0 x 107.9 x 15.0 mm
