snow-wind-001/MecanumWheelvehicle/3D/Hinge 1.SLDPRT

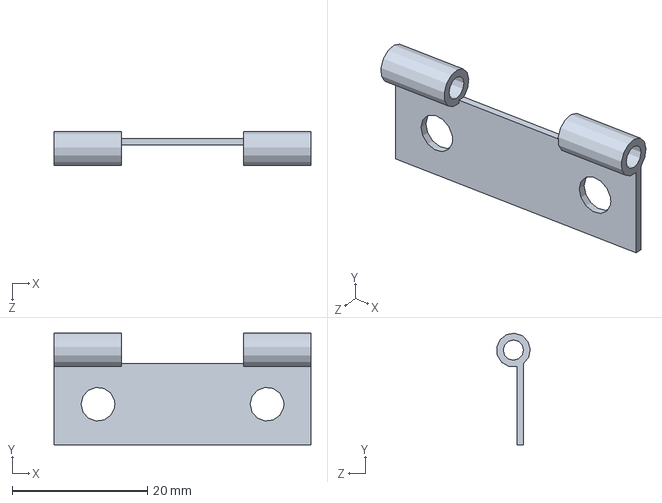
[picture p25: CAD file, 2026-10-25]
3D/Hinge 1.SLDPRT
38.0 x 16.5 x 4.96 mm
