snow-wind-001/MecanumWheelvehicle/3D/2020 Aluminum profile 200mm.SLDPRT

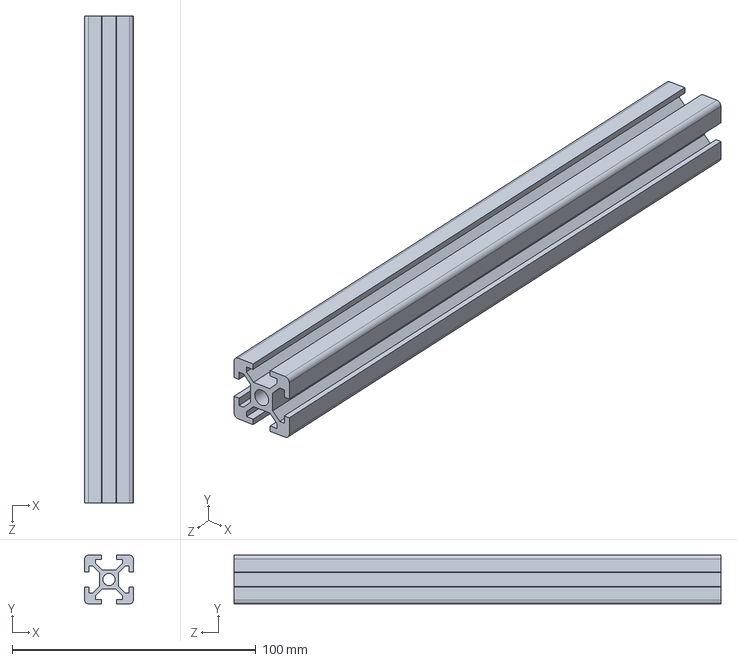
[picture p26: CAD file, 2026-10-25]
3D/2020 Aluminum profile 200mm.SLDPRT
20.0 x 20.0 x 200.0 mm
