snow-wind-001/MecanumWheelvehicle/(list of files, cad)

Other CAD files:
3D/Vehicle Assembled (1).STEP
3D/M3 Nut.SLDPRT
3D/M3x72mm Screw.SLDPRT
3D/Vehicle Layout v15.blend
