snow-wind-001/MecanumWheelvehicle/Code/MecanumB_Control/MecanumB_Control.ioc

Mcu.UserName=STM32F429ZGTx
PA0/WKUP.Signal=S_TIM5_CH1
PA1.Signal=S_TIM5_CH2
PA10.Signal=USART1_RX
PA13.Signal=SYS_JTMS-SWDIO
PA14.Signal=SYS_JTCK-SWCLK
PA15.Signal=S_TIM2_CH1_ETR
PA6.Signal=S_TIM3_CH1
PA7.Signal=S_TIM3_CH2
PA9.Signal=USART1_TX
PB1.Signal=ADCx_IN9
PB12.GPIO_Label=IMU_CS
PB12.Signal=GPIO_Output
PB13.Signal=SPI2_SCK
PB14.Signal=SPI2_MISO
PB15.Signal=SPI2_MOSI
PB3.Signal=S_TIM2_CH2
PB6.Signal=S_TIM4_CH1
PB7.Signal=S_TIM4_CH2
PB8.Signal=I2C1_SCL
PB9.Signal=I2C1_SDA
PC0.Signal=ADCx_IN10
PC1.Signal=ADCx_IN11
PC10.Signal=UART4_TX
PC11.Signal=UART4_RX
PC2.Signal=ADCx_IN12
PC3.Signal=ADCx_IN13
PC4.Signal=ADCx_IN14
PC5.Signal=ADCx_IN15
PC6.GPIO_Label=PI_SHUTDOWN_REQ
PC6.Signal=GPIO_Output
PC7.GPIO_Label=PI_PWR_GOOD
PC7.Signal=GPIO_Input
PC8.GPIO_Label=AUX_PWR_GOOD
PC8.Signal=GPIO_Input
PD0.GPIO_Label=PI_READY
PD0.Signal=GPIO_Input
PD1.GPIO_Label=PI_HALTED
PD1.Signal=GPIO_Input
PD10.GPIO_Label=PWR_ALERT_N
PD10.Signal=GPXTI10
PD11.GPIO_Label=LD06_FAULT_N
PD11.Signal=GPIO_Input
PD12.GPIO_Label=LVL_SHIFT_OE
PD12.Signal=GPIO_Output
PD13.GPIO_Label=LD06_PWR_EN
PD13.Signal=GPIO_Output
PD14.GPIO_Label=DRV_WAKE
PD14.Signal=GPIO_Output
PD2.GPIO_Label=IMU_DRDY
PD2.Signal=GPXTI2
PD3.GPIO_Label=PI_PWR_CMD
PD3.Signal=GPIO_Output
PD4.GPIO_Label=AUX_PWR_EN
PD4.Signal=GPIO_Output
PD5.Signal=USART2_TX
PD6.Signal=USART2_RX
PD7.GPIO_Label=CHG_PRESENT
PD7.Signal=GPIO_Input
PD8.Signal=USART3_TX
PD9.Signal=USART3_RX
PE0.Signal=UART8_RX
PE1.Signal=UART8_TX
PE11.Signal=S_TIM1_CH2
PE13.Signal=S_TIM1_CH3
PE14.Signal=S_TIM1_CH4
PE15.Signal=TIM1_BKIN
PE5.Signal=S_TIM9_CH1
PE9.Signal=S_TIM1_CH1
PF6.Signal=UART7_RX
PF7.Signal=UART7_TX
PG0.GPIO_Label=DIR_FL
PG0.Signal=GPIO_Output
PG1.GPIO_Label=DIR_FR
PG1.Signal=GPIO_Output
PG10.GPIO_Label=MOTOR_ARM_REQ
PG10.Signal=GPIO_Output
PG11.GPIO_Label=ESTOP_OK
PG11.Signal=GPXTI11
PG12.GPIO_Label=MCU_WDI
PG12.Signal=GPIO_Output
PG14.Signal=USART6_TX
PG2.GPIO_Label=DIR_RL
PG2.Signal=GPIO_Output
PG3.GPIO_Label=DIR_RR
PG3.Signal=GPIO_Output
PG4.GPIO_Label=FAULT_FL
PG4.Signal=GPXTI4
PG5.GPIO_Label=FAULT_FR
PG5.Signal=GPXTI5
PG6.GPIO_Label=FAULT_RL
PG6.Signal=GPXTI6
PG7.GPIO_Label=FAULT_RR
PG7.Signal=GPXTI7
PG8.GPIO_Label=GNSS_PPS
PG8.Signal=GPXTI8
PG9.Signal=USART6_RX
PH0/OSC_IN.Signal=RCC_OSC_IN
PH1/OSC_OUT.Signal=RCC_OSC_OUT
PE4.GPIO_Label=ESP_EN
PE4.Signal=GPIO_Output
PE6.GPIO_Label=ESP_BOOT
PE6.Signal=GPIO_Output
