snow-wind-001/MecanumWheelvehicle/(notices)

Notices in the files:
Code/MecanumB_Control/Src/main.c:
Copyright (c) 2026 STMicroelectronics.
All rights reserved.
This software is licensed under terms that can be found in the LICENSE file
